mhamrah/hamrah-arc-58/README.md

# Hamrah Arc 58

A low-profile, split 58-input keyboard built around Kailh Choc v1 hotswap
switches, KEEBD Helios RP2040 controllers, per-key RGB, OLEDs, clickable
encoders, and a fully reversible PCB. The design keeps the approved Sofle Choc
6x4 column-staggered field and replaces the original bottom cluster with a
four-key inward/downward Arc thumb fan.

Each half has 29 press inputs:

- 24 column-staggered main keys;
- four Arc thumb keys; and
- one clickable rotary encoder.

## Layout preview

Hamrah Arc 58 Rev Gamma rounded layout

[Open the full-size SVG](output/keyboard-layout.svg)

## Geometry

All dimensions live in `layout.config.json`.

| Parameter | Value |
| --- | ---: |
| Main matrix pitch | 19.05 x 19.05 mm |
| Choc plate cutout | 14 x 14 mm |
| Specified Choc v1 keycap | 16.5 x 16.5 mm |
| Choc keys per half | 28 |
| Clickable encoders per half | 1 |
| EC11 body plate cutout | 12.5 x 12.5 mm |
| Encoder knob-to-C6 / knob-to-inner-edge gap | 9.17 mm / 9.17 mm |
| Thumb center spacing | 21.25 mm |
| T1 outward offset from C5/C6 midpoint | 1.0 mm |
| Conservative thumb envelope / minimum gap | 18 x 18 mm / 0.5 mm |
| Thumb key rotations | 10, 30, 45, 55 degrees |
| Mounting holes per half | 6 x 2.2 mm |

## Generate and verify

Node.js 18 or newer and KiCad 9 are required.

```sh
npm run generate
npm run verify
npm run generate:enclosures
```

Generation creates the mirrored layout, a US Letter 1:1 paper test, exact key
positions, and left/right top and bottom plate SVG/DXF files under `output/`.
Print the paper test at Actual Size / 100% and confirm its calibration bar is
exactly 50 mm before ordering plates.

`generate:enclosures` additionally creates vendor ZIP packages for 1.5 mm
acrylic top plates, 3 mm acrylic bottom plates, and a 6061-T6 machined aluminum
case under `output/manufacturing/`. It uses `uv` with Python 3.12 to run the
CadQuery solid-model generator. Material, tolerances, fit-coupon instructions,
and the nominal hardware stack are documented in
[`hardware/ENCLOSURES.md`](hardware/ENCLOSURES.md).

The single native PCB project is:

```text
hardware/kicad/arc58-reversible.kicad_pro
hardware/kicad/arc58-reversible.kicad_pcb
```

Order two copies of the same Rev Gamma PCB. In the assembled keyboard, the B.Cu
face points toward the keycaps on the left half and the F.Cu face points toward
the keycaps on the right half. Detailed component-side selection, verified pin
mapping, DRC status, and safety notes are in `hardware/README.md`; the pair BOM is
`hardware/BOM-REV-GAMMA.csv`.

Rev Gamma supersedes Rev Beta without changing any switch center, plate, or
case geometry. It moves D26-D29 into solder-friendly positions beside the four
thumb sockets, gives the inner D29 extra socket-body clearance, and reroutes
the affected reversible copper with no jumper. Rev Beta can be electrically
prototyped, but its inner thumb diode crowds the Choc socket and its outer
thumb diodes require awkward long reaches; do not reorder it.

Do not build or reorder Rev Alpha: it has no routed optical/package apertures
for per-key RGB, its TRRS jack points toward the encoder instead of the cable
exit, and its four thumb-switch axes are mirrored to the wrong physical
angles. Its 20.5 mm thumb centers also fail the conservative 18 x 18 mm
clearance requirement. Rev Alpha may be electrically bench-tested with every
RGB LED omitted and without an enclosure, but it does not implement the
intended keyboard.

## Prototype status

The routed board passes the repository's structural and electrical checks:
zero unrouted connections and zero shorts, crossings, or fabrication-clearance
violations. Its Edge.Cuts layer contains 28 closed 3.6 x 3.1 mm RGB apertures
per half, and the inner-edge TRRS jack/plate geometry provides a 10 mm cable
opening. The switch locator holes independently verify the assembled thumb
axes: +10, +30, +45, and +55 degrees on the B.Cu/left half, mirrored to -10,
-30, -45, and -55 degrees on the F.Cu/right half. T3 eases five degrees outward;
T4 eases fifteen degrees outward and its center moves 3.14 mm toward the side
and 2.59 mm upward from the former 70-degree position. The thumb centers remain
21.25 mm apart and preserve more than 0.5 mm nominal clearance for a
conservative 18 x 18 mm keycap envelope. The specified 16.5 x 16.5 mm caps
retain approximately 2.3 mm minimum clearance, with the T3-T4 gap increased to
approximately 3.44 mm. QMK is configured for
Helios, a one-wire TRRS split, OLED, encoder, and a 28+28 RGB Matrix. The
default firmware also compiles successfully against current upstream QMK; the
ignored local UF2 is generated at
`output/firmware/arc58-rev-gamma-default.uf2`.

This is still a prototype until a fabricated pair passes
`hardware/BRING-UP-CHECKLIST.md`. Choc switches plug into soldered hotswap
sockets; the switches themselves are not soldered to the PCB. Use a small
prototype order and verify switch/plate fit, diode and LED orientation, USB
current, every key, both encoders, both OLEDs, RGB, and the split link before a
larger run.
