mhamrah/hamrah-arc-58/hardware/kicad/variants/gamma-direct/arc58-gamma-direct.kicad_pcb

## KiCad design hardware/kicad/variants/gamma-direct/arc58-gamma-direct.kicad_pcb (2026-10-29)

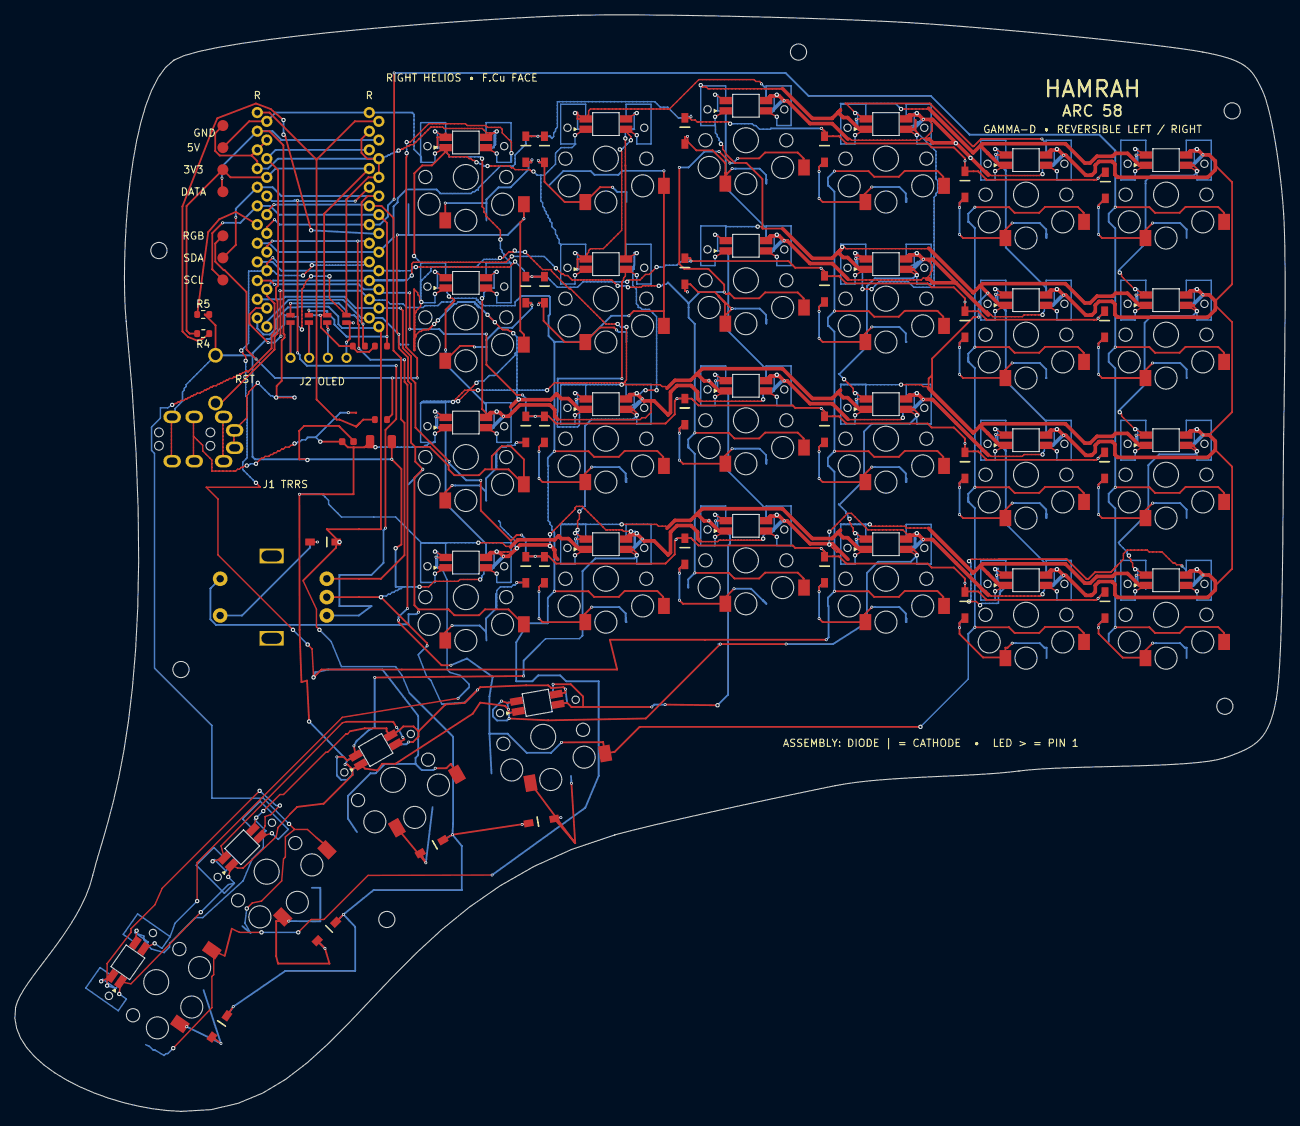
[picture p1: board arc58-gamma-direct.kicad_pcb from above]

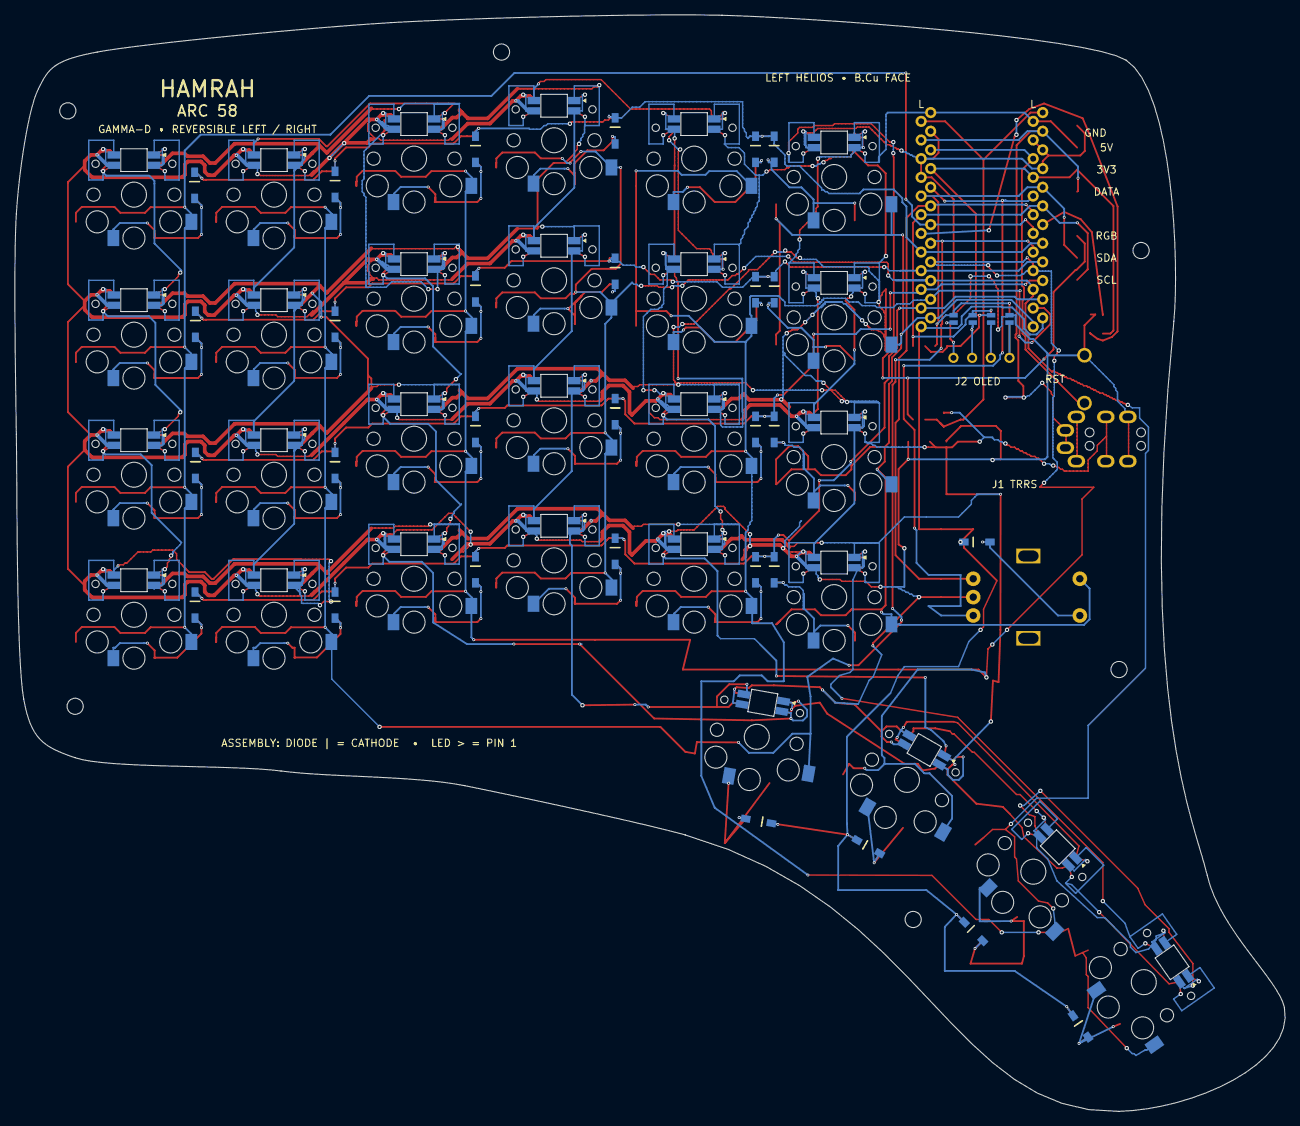
[picture p2: board arc58-gamma-direct.kicad_pcb from below]

Board: 2 copper layers, 172.8 x 149.2 mm, 90 parts (4 on the bottom side), 84 nets.

Parts:
C1: 100nF; C_0603_1608Metric
C2: 47uF 10V; C_1206_3216Metric
D1, D2, D3, D4, D5, D6, D7, D8, D9, D10, D11, D12, D13, D14, D15, D16, D17, D18, D19, D20, D21, D22, D23, D24, D25, D26, D27, D28, D29: D; Reversible_Diode_SOD123
H1, H2, H3, H4, H5, H6: MountingHole_2.2mm_M2
J1: MJ-4PP-9_Reversible; CON_MJ-4PP-9_Reversible
J2: SSD1306 OLED 128x32; OLED_4Pin
JP1, JP2, JP3, JP4, JP5, JP6, JP7, JP8: Jumper_NO_Small; Jumper
R1: 330R; R_0603_1608Metric
R2, R3: 4.7k; R_0603_1608Metric
R4, R5: 10k; R_0603_1608Metric
RST1: RESET; TACT_SWITCH_TVBP06
SW1, SW2, SW3, SW4, SW5, SW6, SW7, SW8, SW9, SW10, SW11, SW12, SW13, SW14, SW15, SW16, SW17, SW18, SW19, SW20, SW21, SW22, SW23, SW24, SW26, SW27, SW28, SW29: SW_PUSH_LED; Sofle_Choc_Hotswap_SK6812MINI-E_Reversible
SW25: EC11_Clickable_H20mm_T18; RotaryEncoder_Alps_EC11E-Switch_Vertical_H20mm-keebio_modif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
TP1, TP2, TP3, TP4, TP6, TP7, TP8: TestPoint_Pad_D1.5mm
U1: KEEBD Helios RP2040; ProMicro

Connections:
COL0: SW6.6, SW12.6, SW18.6, SW24.6, U1.18
COL1: SW5.6, SW11.6, SW17.6, SW23.6, SW29.6, U1.17
COL2: SW4.6, SW10.6, SW16.6, SW22.6, SW28.6, U1.16
COL3: SW3.6, SW9.6, SW15.6, SW21.6, SW27.6, U1.15
COL4: SW2.6, SW8.6, SW14.6, SW20.6, SW26.6, U1.14
COL5: SW1.6, SW7.6, SW13.6, SW19.6, SW25.S1, U1.13
ENC_A: SW25.A, U1.20
ENC_B: SW25.B, U1.19
GND: C1.2, C2.2, J1.S, JP1.2, JP8.2, R5.2, RST1.1, SW1.3, SW2.3, SW3.3, SW4.3, SW5.3, SW6.3, SW7.3, SW8.3, SW9.3, SW10.3, SW11.3, SW12.3, SW13.3, SW14.3, SW15.3, SW16.3, SW17.3, SW18.3, SW19.3, SW20.3, SW21.3, SW22.3, SW23.3, SW24.3, SW25.C, SW26.3, SW27.3, SW28.3, SW29.3, TP1.1, U1.3, U1.4, U1.23
HAND_L: R4.1, U1.L7
HAND_R: R5.1, U1.7
KEY_ENC: D25.2, SW25.S2
unnamed: D1.2, SW1.5
unnamed: D2.2, SW2.5
unnamed: D3.2, SW3.5
unnamed: D4.2, SW4.5
unnamed: D5.2, SW5.5
unnamed: D6.2, SW6.5
unnamed: D7.2, SW7.5
unnamed: D8.2, SW8.5
unnamed: D9.2, SW9.5
unnamed: D10.2, SW10.5
unnamed: D11.2, SW11.5
unnamed: D12.2, SW12.5
unnamed: D13.2, SW13.5
unnamed: D14.2, SW14.5
unnamed: D15.2, SW15.5
unnamed: D16.2, SW16.5
unnamed: D17.2, SW17.5
unnamed: D18.2, SW18.5
unnamed: D19.2, SW19.5
unnamed: D20.2, SW20.5
unnamed: D21.2, SW21.5
unnamed: D22.2, SW22.5
unnamed: D23.2, SW23.5
unnamed: D24.2, SW24.5
unnamed: D26.2, SW26.5
unnamed: D27.2, SW27.5
unnamed: D28.2, SW28.5
unnamed: D29.2, SW29.5
unnamed: J2.1, JP4.1, JP8.1
unnamed: J2.2, JP3.1, JP7.1
unnamed: J2.3, JP2.1, JP6.1
unnamed: J2.4, JP1.1, JP5.1
unnamed: SW1.2, SW7.4
unnamed: SW2.2, SW3.4
unnamed: SW2.4, SW8.2
unnamed: SW3.2, SW9.4
unnamed: SW4.2, SW5.4
unnamed: SW4.4, SW10.2
unnamed: SW10.4, SW16.2
unnamed: SW11.2, SW17.4
unnamed: SW5.2, SW11.4
unnamed: SW6.4, SW12.2
unnamed: SW12.4, SW18.2
unnamed: SW13.2, SW19.4
unnamed: SW7.2, SW13.4
unnamed: SW8.4, SW14.2
unnamed: SW14.4, SW20.2
unnamed: SW15.2, SW21.4
unnamed: SW9.2, SW15.4
unnamed: SW16.4, SW22.2
unnamed: SW17.2, SW23.4
unnamed: SW18.4, SW24.2
unnamed: SW19.2, SW26.4
unnamed: SW20.4, SW28.2
unnamed: SW21.2, SW29.4
unnamed: SW23.2, SW24.4
unnamed: SW26.2, SW27.4
unnamed: SW27.2, SW28.4
unnamed: SW22.4, SW29.2
OLED_SCL: JP3.2, JP6.2, R3.2, TP8.1, U1.6
OLED_SDA: JP4.2, JP5.2, R2.2, TP7.1, U1.5
RESET: RST1.2, U1.22
RGB_LED_IN: R1.2, SW1.4, TP6.1
RGB_MCU: R1.1, U1.1
ROW0: D1.1, D2.1, D3.1, D4.1, D5.1, D6.1, U1.8
ROW1: D7.1, D8.1, D9.1, D10.1, D11.1, D12.1, U1.9
ROW2: D13.1, D14.1, D15.1, D16.1, D17.1, D18.1, U1.10
ROW3: D19.1, D20.1, D21.1, D22.1, D23.1, D24.1, U1.11
ROW4: D25.1, D26.1, D27.1, D28.1, D29.1, U1.12
SPLIT_DATA: J1.T, TP4.1, U1.2
VBUS: C1.1, C2.1, J1.R2, SW1.1, SW2.1, SW3.1, SW4.1, SW5.1, SW6.1, SW7.1, SW8.1, SW9.1, SW10.1, SW11.1, SW12.1, SW13.1, SW14.1, SW15.1, SW16.1, SW17.1, SW18.1, SW19.1, SW20.1, SW21.1, SW22.1, SW23.1, SW24.1, SW26.1, SW27.1, SW28.1, SW29.1, TP2.1, U1.24
VCC3V3: JP2.2, JP7.2, R2.1, R3.1, R4.2, TP3.1, U1.21
