mhamrah/hamrah-arc-58/(commit log)

2026-07-30 Initial Hamrah Arc 58 design
    [left-half-plate.dxf]
2026-08-02 Complete reversible Arc 58 Rev B design
    [BOM-REV-B.csv, arc58-reversible.kicad_pcb, left-half-plate.dxf]
2026-08-02 Complete Arc 58 Rev Alpha design
    [BOM-REV-ALPHA.csv, arc58-reversible.kicad_pcb]
2026-08-02 Remove obsolete PCB guide lines
    [arc58-reversible.kicad_pcb]
2026-08-02 Finalize smooth Rev Alpha outline
    [arc58-reversible.kicad_pcb]
2026-08-02 Add acrylic and CNC enclosure generation
    [BOM-REV-ALPHA.csv]
2026-08-10 Fix RGB apertures and TRRS clearance
    [BOM-REV-BETA.csv, arc58-reversible.kicad_pcb]
2026-08-11 Fix reversible thumb switch axes
    [BOM-REV-BETA.csv, arc58-reversible.kicad_pcb]
2026-08-11 Clarify Helios handedness assembly
    [BOM-REV-BETA.csv, arc58-reversible.kicad_pcb]
2026-08-11 Fix thumb keycap clearance
    [BOM-REV-BETA.csv, arc58-reversible.kicad_pcb]
2026-08-11 Tighten thumb key spacing
    [BOM-REV-BETA.csv, arc58-reversible.kicad_pcb]
2026-08-11 Move encoders inward for knob clearance
    [BOM-REV-BETA.csv, arc58-reversible.kicad_pcb]
2026-08-11 Center encoder clearance
    [BOM-REV-BETA.csv, arc58-reversible.kicad_pcb]
2026-08-11 Refine T3 and T4 thumb sweep
    [arc58-reversible.kicad_pcb]
2026-08-11 Reshape thumb-side PCB outline
    [arc58-reversible.kicad_pcb]
2026-08-12 new layout
    [BOM-REV-BETA.csv, arc58-reversible.kicad_pcb]
2026-08-13 Correct Rev Beta PCB and fabrication outputs
    [BOM-REV-BETA.csv, arc58-reversible.kicad_pcb]
2026-08-13 Remove dangling copper from Rev Beta PCB
    [arc58-reversible.kicad_pcb]
2026-08-13 Simplify Rev Beta copper routing
    [arc58-reversible.kicad_pcb]
2026-08-31 Update Arc 58 firmware for Elite-Pi
    [BOM-REV-GAMMA.csv, arc58-reversible.kicad_pcb]
2026-09-03 fix keyboard layout
    [arc58-reversible.kicad_pcb]
2026-10-29 Add Gamma-D direct RGB prototype and verification support
    [BOM-GAMMA-D.csv, arc58-gamma-direct.kicad_pcb]
